raduvadim/poor-mans-hardware/README.md

poor-mans-hardware
==================

open source equipment for engineer's workbench.
