raduvadim/poor-mans-hardware/statie_lipit/development/software/README.md

poor-mans-hardware
==================
Fisierele sunt compilate in Atmel Studio 6

Fisierele sunt bazate pe cod din: https://www.openhub.net/p/avr-pid-solder-station?ref=sample

In prezent, modificari de facut:
 - control digital al temperaturii(din butoane)
 - implementare corecta afisaj
 - etc.

Modificari realizate de la prima revizie
 - exindere control pe seriala 
 - implementare corecta pentru libraria integratului MAX 31855
