raduvadim/poor-mans-hardware/statie_lipit/development/hardware/control.brd

## EAGLE design statie_lipit/development/hardware/control.brd (2014-07-28)

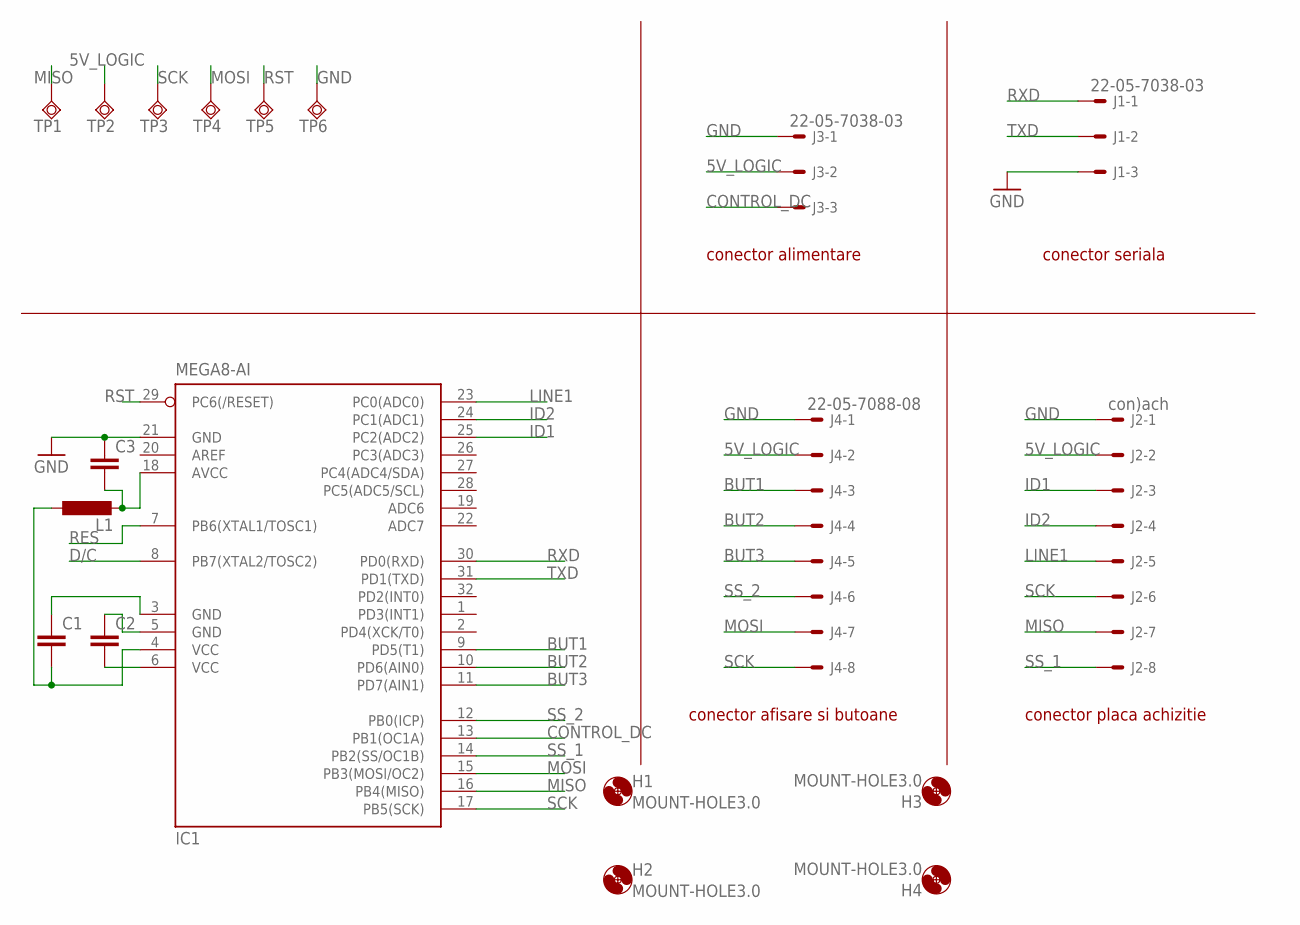
[picture p1: schematic control.sch]

Parts:
C1, C2, C3: C-EUC0805K; C0805K
H1, H2, H3, H4: MOUNT-HOLE3.0; 3,0
IC1: MEGA8-AI; TQFP32-08
J1, J3: 22-05-7038-03; 7395-03
J2: con)ach; 7395-08
J4: 22-05-7088-08; 7395-08
L1: L-EU0204/7; 0204/7
TP1, TP2, TP3, TP4, TP5, TP6: TPSQPAD1-13; P1-13

Connections:
5V_LOGIC: C1.2, C2.2, IC1.4 (VCC), IC1.6 (VCC), J2.2, J3.2, J4.2, L1.1, TP2.TP
BUT1: IC1.9 (PD5(T1)), J4.3
BUT2: IC1.10 (PD6(AIN0)), J4.4
BUT3: IC1.11 (PD7(AIN1)), J4.5
CONTROL_DC: IC1.13 (PB1(OC1A)), J3.3
D/C: IC1.8 (PB7(XTAL2/TOSC2))
GND: C1.1, C2.1, C3.1, IC1.3 (GND), IC1.5 (GND), IC1.21 (GND), J1.3, J2.1, J3.1, J4.1, TP6.TP
ID1: IC1.25 (PC2(ADC2)), J2.3
ID2: IC1.24 (PC1(ADC1)), J2.4
LINE1: IC1.23 (PC0(ADC0)), J2.5
MISO: IC1.16 (PB4(MISO)), J2.7, TP1.TP
MOSI: IC1.15 (PB3(MOSI/OC2)), J4.7, TP4.TP
unnamed: C3.2, IC1.18 (AVCC), L1.2
RES: IC1.7 (PB6(XTAL1/TOSC1))
RST: IC1.29 (PC6(/RESET)), TP5.TP
RXD: IC1.30 (PD0(RXD)), J1.1
SCK: IC1.17 (PB5(SCK)), J2.6, J4.8, TP3.TP
SS_1: IC1.14 (PB2(SS/OC1B)), J2.8
SS_2: IC1.12 (PB0(ICP)), J4.6
TXD: IC1.31 (PD1(TXD)), J1.2

Notes on the sheet:
conector seriala
conector placa achizitie
conector alimentare
conector afisare si butoane

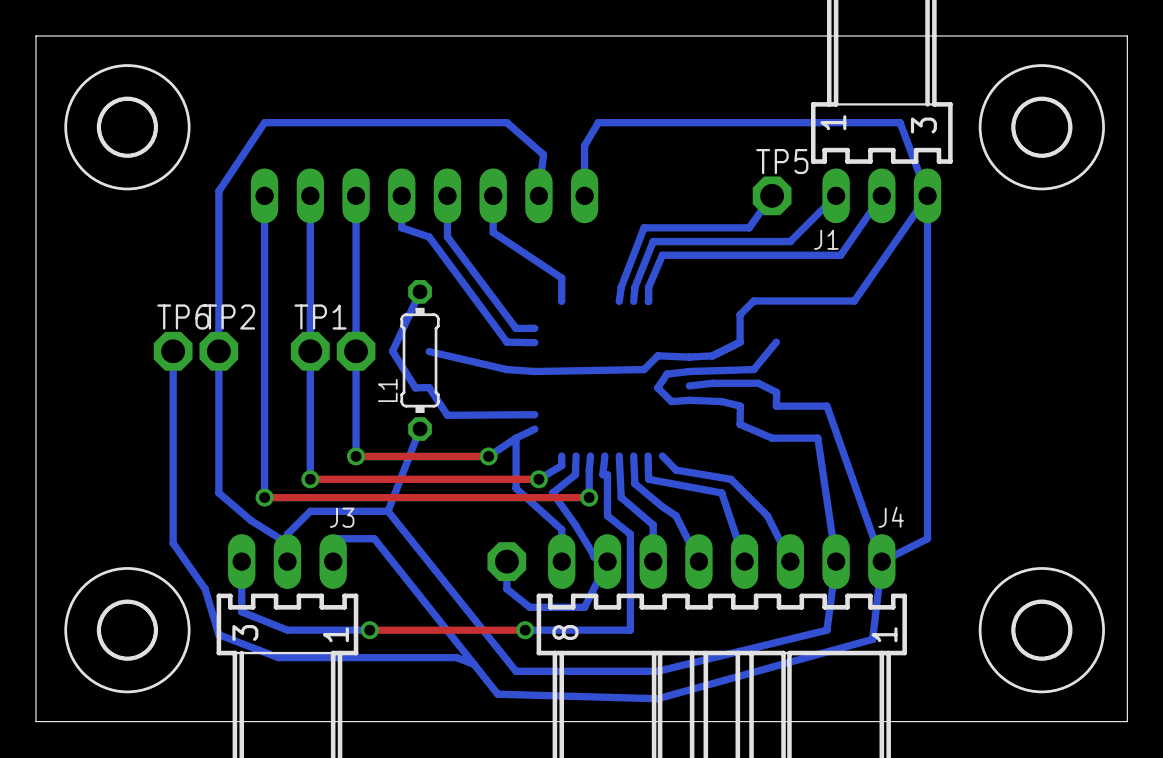
[picture p2: board control.brd from above]

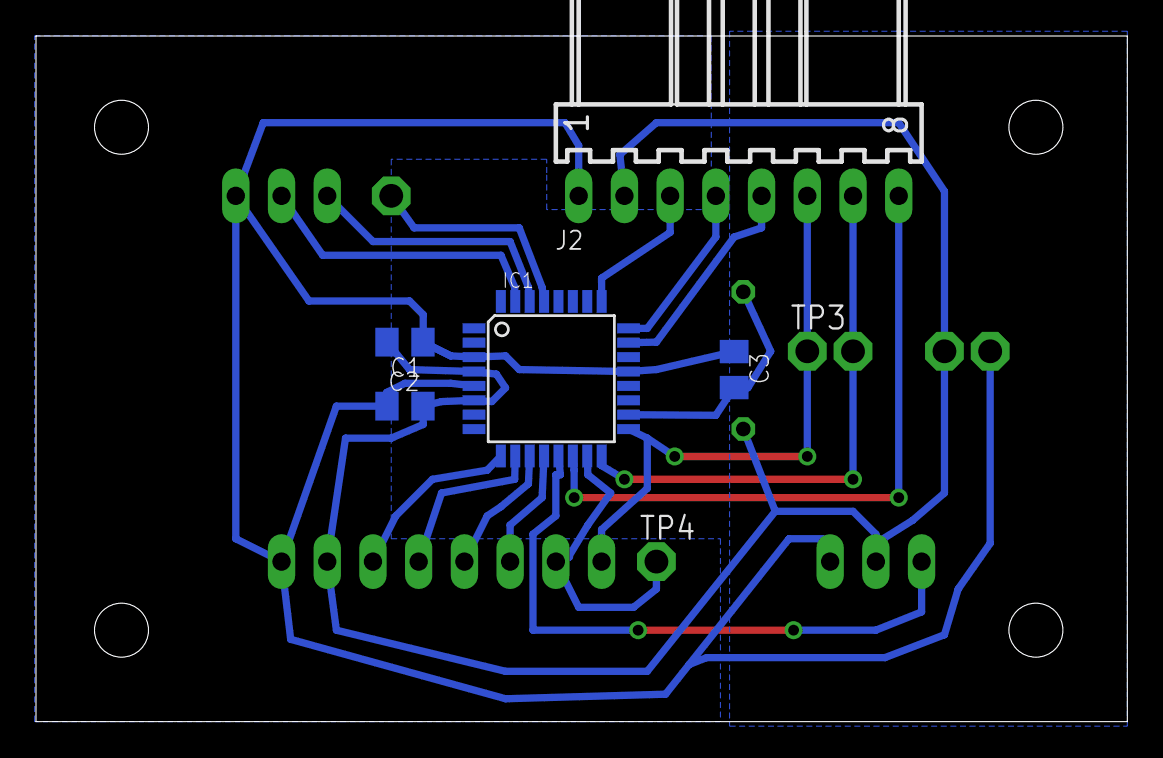
[picture p3: board control.brd from below]

Board: 2 copper layers, 60.6 x 38.1 mm, 19 parts (7 on the bottom side), 18 nets.
