raduvadim/poor-mans-hardware/statie_lipit/development/hardware/achizitie.brd

## EAGLE design statie_lipit/development/hardware/achizitie.brd (2014-07-23)

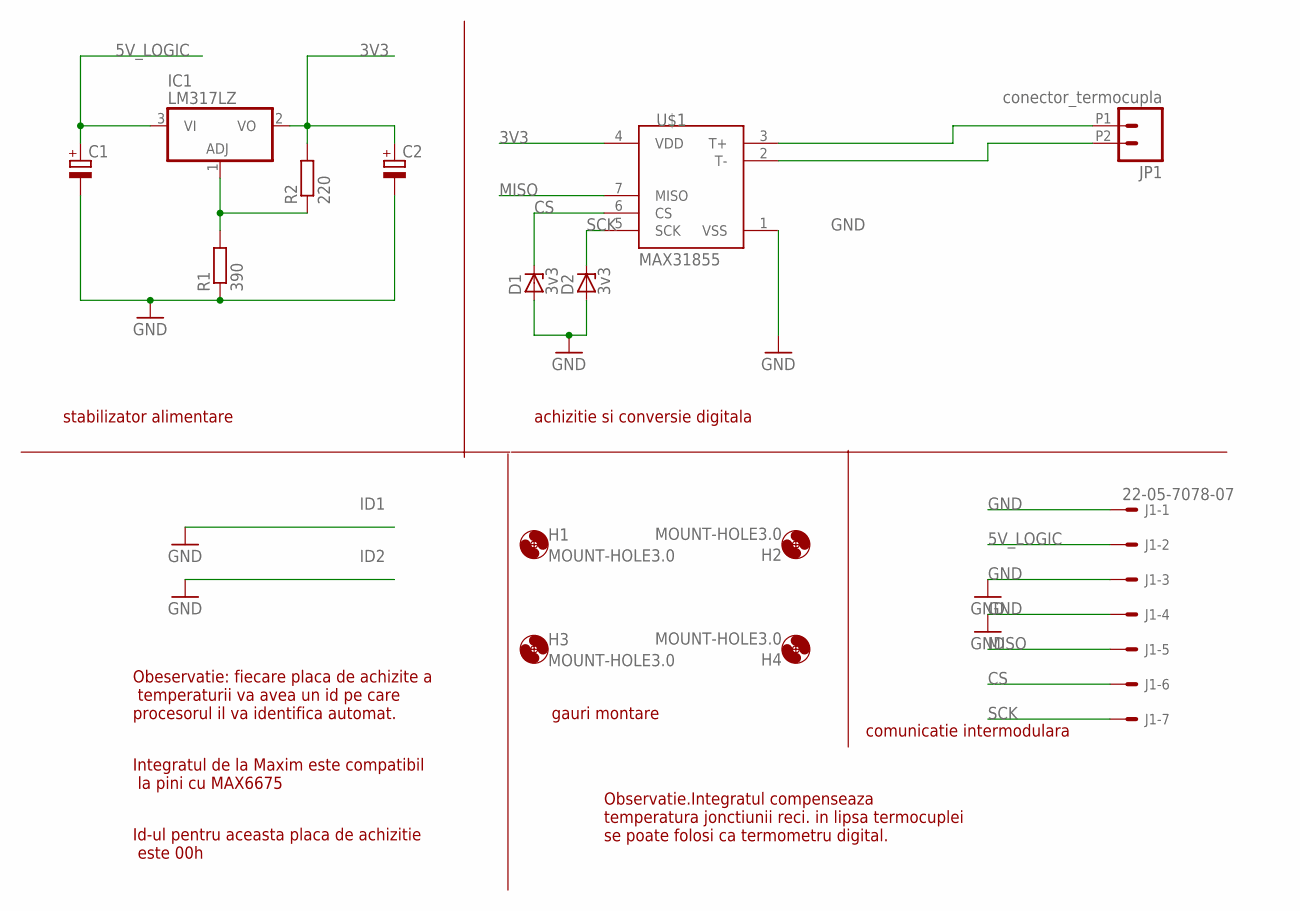
[picture p4: schematic achizitie.sch]

Parts:
C1, C2: CPOL-EUE2,5-6E; E2,5-6E
D1, D2: 3v3; SOD80C
H1, H2, H3, H4: MOUNT-HOLE3.0; 3,0
IC1: LM317LZ; TO92
J1: 22-05-7078-07; 7395-07
JP1: conector_termocupla; 1X02_2.54_SCREWTERM
R1: 390; M1206
R2: 220; M1206
U$1: MAX31855; SO08-MAX6675

Connections:
3V3: C2.+, IC1.2 (VO), R2.2, U$1.4 (VDD)
5V_LOGIC: C1.+, IC1.3 (VI), J1.2
CS: D1.C, J1.6, U$1.6 (CS)
GND: C1.-, C2.-, D1.A, D2.A, J1.1, J1.3, J1.4, R1.1, U$1.1 (VSS)
MISO: J1.5, U$1.7 (MISO)
unnamed: IC1.1 (ADJ), R1.2, R2.1
unnamed: JP1.P1 (1), U$1.3 (T+)
unnamed: JP1.P2 (2), U$1.2 (T-)
SCK: D2.C, J1.7, U$1.5 (SCK)

Notes on the sheet:
Obeservatie: fiecare placa de achizite a temperaturii va avea un id pe care procesorul il va identifica automat.
Integratul de la Maxim este compatibil la pini cu MAX6675
Id-ul pentru aceasta placa de achizitie este 00h
stabilizator alimentare
achizitie si conversie digitala
gauri montare
comunicatie intermodulara
Observatie.Integratul compenseaza temperatura jonctiunii reci. in lipsa termocuplei se poate folosi ca termometru digital.

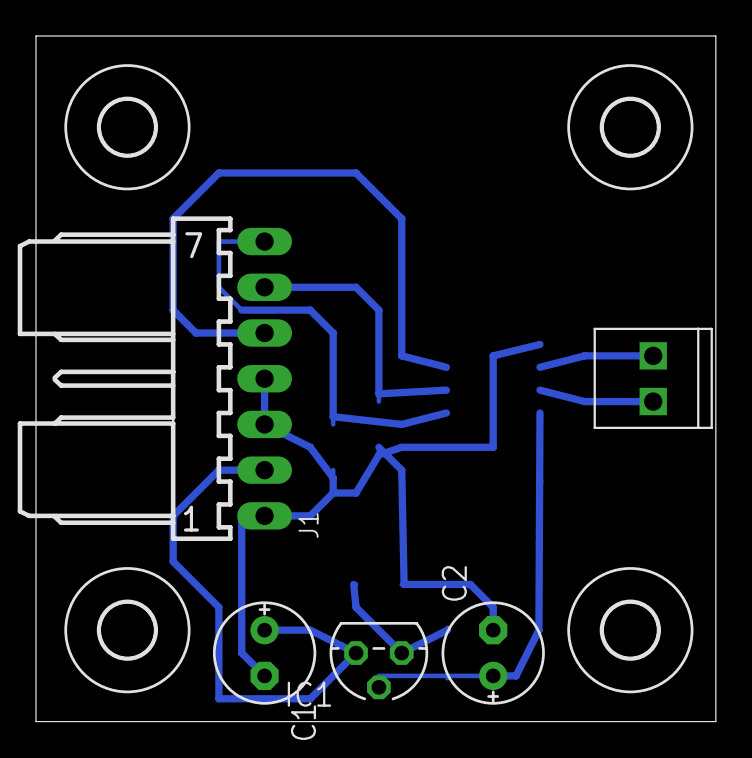
[picture p5: board achizitie.brd from above]

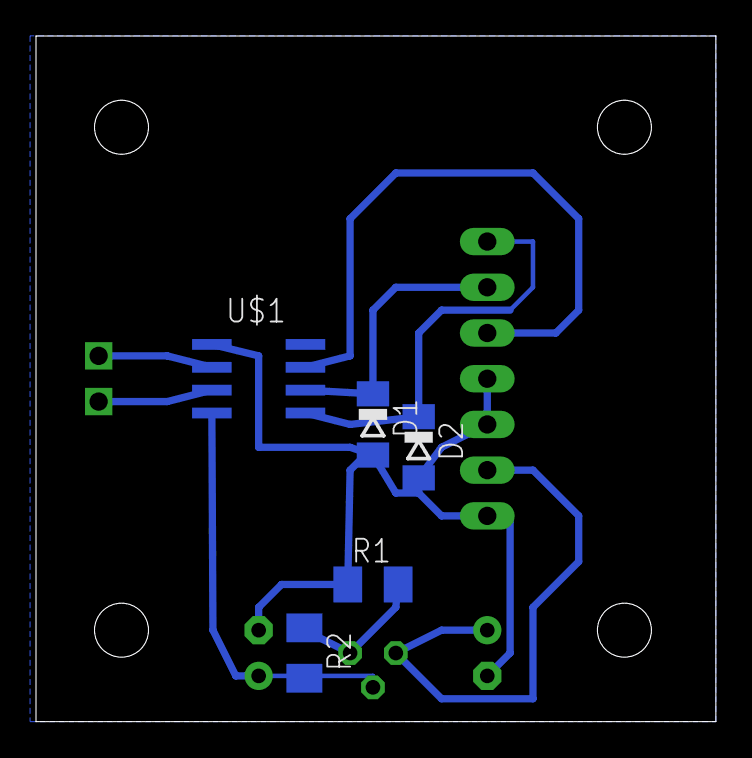
[picture p6: board achizitie.brd from below]

Board: 2 copper layers, 37.8 x 38.1 mm, 14 parts (5 on the bottom side), 9 nets.
