raduvadim/poor-mans-hardware/statie_lipit/development/hardware/alimentare_no_ac.brd

## EAGLE design statie_lipit/development/hardware/alimentare_no_ac.brd (2014-07-23)

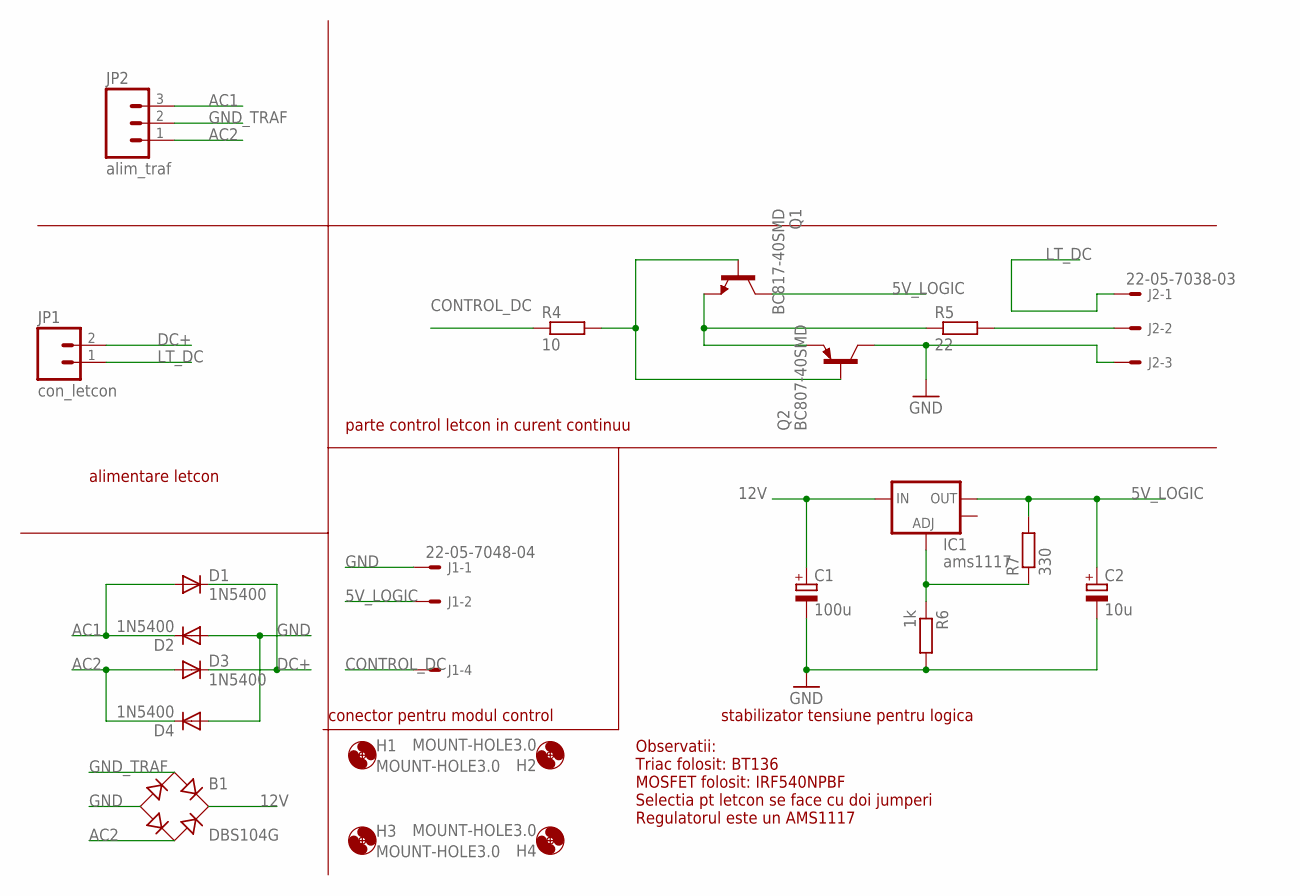
[picture p7: schematic alimentare_no_ac.sch]

Parts:
B1: DBS104G; DBS
C1: 100u; E2,5-6E
C2: 10u; E2,5-6E
D1, D2, D3, D4: 1N5400; DO201-15
H1, H2, H3, H4: MOUNT-HOLE3.0; 3,0
IC1: ams1117; SOT223
J1: 22-05-7048-04; 7395-04
J2: 22-05-7038-03; 7395-03
JP1: con_letcon; SCREWTERMINAL-3.5MM-2
JP2: alim_traf; SCREWTERMINAL-3.5MM-3
Q1: BC817-40SMD; SOT23-BEC
Q2: BC807-40SMD; SOT23-BEC
R4: 10; M1206
R5: 22; M1206
R6: 1k; M1206
R7: 330; M1206

Connections:
5V_LOGIC: C2.+, IC1.2 (OUT), J1.2, Q1.C, R7.2
12V: B1.+, C1.+, IC1.3 (IN)
AC1: D1.A, D2.C, JP2.3
AC2: B1.AC2, D3.A, D4.C, JP2.1
CONTROL_DC: J1.4, R4.1
DC+: D1.C, D3.C, JP1.2
GND: B1.-, C1.-, C2.-, D2.A, D4.A, J1.1, J2.3, Q2.C, R6.2
GND_TRAF: B1.AC1, JP2.2
LT_DC: J2.1, JP1.1
unnamed: J2.2, R5.2
unnamed: Q1.E, Q2.E, R5.1
unnamed: Q1.B, Q2.B, R4.2
unnamed: IC1.1 (ADJ), R6.1, R7.1

Notes on the sheet:
parte control letcon in curent continuu
stabilizator tensiune pentru logica
conector pentru modul control
Observatii: Triac folosit: BT136 MOSFET folosit: IRF540NPBF Selectia pt letcon se face cu doi jumperi Regulatorul este un AMS1117
alimentare letcon

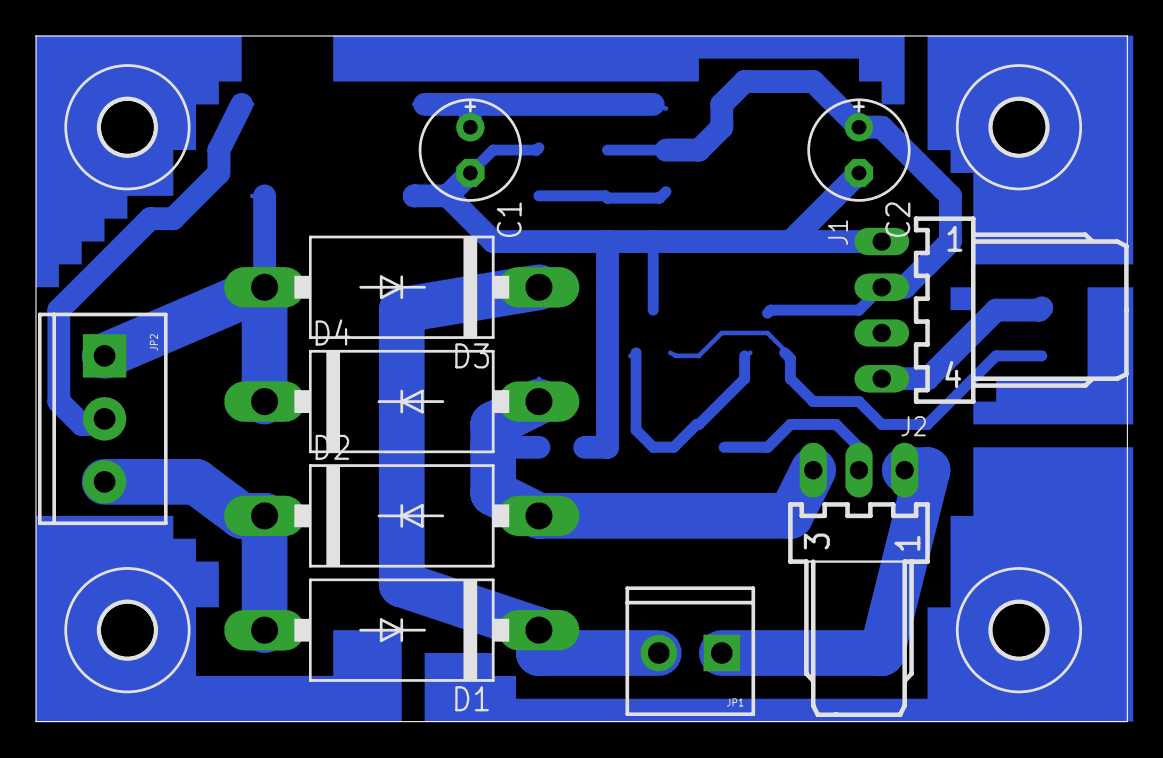
[picture p8: board alimentare_no_ac.brd from above]

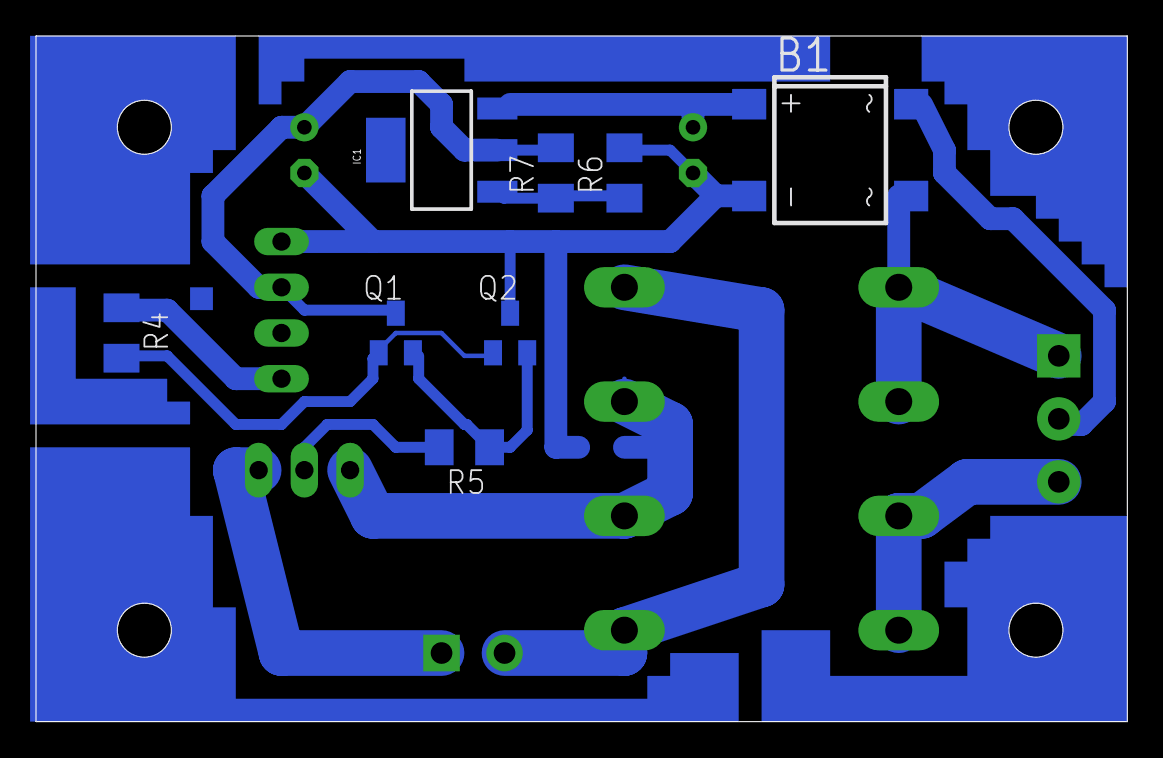
[picture p9: board alimentare_no_ac.brd from below]

Board: 2 copper layers, 60.6 x 38.1 mm, 22 parts (8 on the bottom side), 13 nets.
