raduvadim/poor-mans-hardware/statie_lipit/development/software/digit.h

/*
 * led_7segment.h
 *
 *  Created on: 2008-11-28
 *      Author: wodz
 */

#ifndef DIGIT_H_
#define DIGIT_H_

void digit_print(uint8_t number);
void digit_refresh(uint8_t nr1, uint8_t nr2, uint8_t nr3, uint8_t nr4);

#endif /* DIGIT_H_ */
