raduvadim/poor-mans-hardware/(commit log)

2014-07-23 primele versiuni de placa
    [achizitie.brd, achizitie.sch, alimentare.sch, alimentare_no_ac.brd, alimentare_no_ac.sch, control.sch]
2014-07-23 prima versiune de software
2014-07-26 revizie 1.1
    Au fost redefinite intreruperile.
    A fost adaugat controlul temperaturii pe interfata seriala.
2014-07-26 revizie 2.0
    oarecum limitata in functionalitate, se poate regla doar de pe portul
    serial.
2014-07-28 new hardware design
    [control.brd, control.sch]
